unregist/mhi-ac-ctrl-esp32-c3/esphome/components/MhiAcCtrl/MHI-AC-Ctrl-core.cpp

// MHI-AC-Ctrol-core
// implements the core functions (read & write SPI)

#include "MHI-AC-Ctrl-core.h"

#include "freertos/FreeRTOS.h"
#include "freertos/task.h"
#include <math.h>
#include <string.h>

#include "driver/timer.h"
#include "driver/spi_slave.h"
#include "driver/gpio.h"
#define LOG_LOCAL_LEVEL ESP_LOG_DEBUG
#include "esp_log.h"
static const char *TAG = "MHI-AC-CTRL-core";

using namespace mhi_ac;
using namespace mhi_ac::internal;


#define vTaskDelayMs(ms)            vTaskDelay((ms)/portTICK_PERIOD_MS)

#define ESP_INTR_FLAG_DEFAULT       0                                           // default to allocating a non-shared interrupt of level 1, 2 or 3.

#define TIMER_DIVIDER               (16)                                        // hardware timer clock divider
#define TIMER_SCALE_MS              (TIMER_BASE_CLK / TIMER_DIVIDER / 1000)     // convert counter value to milliseconds

static TaskHandle_t mhi_poll_task_handle = NULL;
//                              sb0   sb1   sb2   db0   db1   db2   db3   db4   db5   db6   db7   db8   db9  db10  db11  db12  db13 (db14  chkH  chkL not needed)
static uint8_t miso_frame[] = { 0xA9, 0x00, 0x07, 0x00, 0x00, 0x00, 0xff, 0x00, 0x00, 0x00, 0x00, 0x00, 0x00, 0xff, 0xff, 0xff, 0x0f };
static SemaphoreHandle_t miso_semaphore_handle;
static StaticSemaphore_t miso_semaphore_buffer;

static int gpio_status = 0;
static int ready = 0;
static bool active_mode = false;


static SemaphoreHandle_t snapshot_semaphore_handle;
static StaticSemaphore_t snapshot_semaphore_buffer;
static uint8_t mosi_frame_snapshot[DB14];
static uint8_t mosi_frame_snapshot_prev[DB14];
static uint32_t frame_errors = 0;

namespace mhi_ac {
MHIEnergy mhi_energy(230);


static void IRAM_ATTR gpio_isr_handler(void* arg)
{
    timer_set_counter_value(TIMER_GROUP_0, TIMER_0, 0);
    timer_set_alarm(TIMER_GROUP_0, TIMER_0, TIMER_ALARM_EN);
    //timer_start(TIMER_GROUP_0, TIMER_0);
}

static bool IRAM_ATTR timer_group_isr_callback(void *args)
{
    esp_err_t err;
    BaseType_t xHigherPriorityTaskWoken;
    // Trigger Chip Select
    gpio_set_level(GPIO_CS_OUT, 1);
    if(ready) {
        spi_slave_transaction_t *t = (spi_slave_transaction_t *) args;
        err = spi_slave_queue_trans(RCV_HOST, t, 0);
    }
    //if(err) {
        //gpio_status = 1-gpio_status;
        //gpio_set_level(GPIO_IDK, gpio_status);
    //}
    //gpio_status = 1-gpio_status;
    gpio_set_level(GPIO_CS_OUT, 0);
    //timer_set_counter_value(TIMER_GROUP_0, TIMER_0, 0);
    //timer_set_alarm(TIMER_GROUP_0, TIMER_0, TIMER_ALARM_EN);
    //timer_start(TIMER_GROUP_0, TIMER_0);
    return false;
}

bool mhi_ac_ctrl_core_snapshot(uint32_t wait_time_ms) {
    xSemaphoreTake(snapshot_semaphore_handle, 0);
    return xSemaphoreTake(snapshot_semaphore_handle, pdMS_TO_TICKS(wait_time_ms));
}

void mhi_ac_ctrl_core_active_mode_set(bool state) {
    active_mode = state;
    if(!active_mode) {
        // Ensure we stop counting power when active mode is off
        mhi_energy.set_current(0);
    }
}

bool mhi_ac_ctrl_core_active_mode_get() {
    return active_mode;
}

#define CLAMP(x, lower, upper) (MIN(upper, MAX(x, lower)))

void mhi_ac_ctrl_core_target_temperature_set(float target_temperature) {
    xSemaphoreTake(miso_semaphore_handle, portMAX_DELAY);
    //uint8_t tsetpoint = (uint8_t)roundf(CLAMP(target_temperature*2, 18.f*2, 30.f*2));
    uint8_t tsetpoint = (uint8_t)roundf(CLAMP(target_temperature*2, 0.f*2, 30.f*2));
    miso_frame[DB2] = tsetpoint;
    miso_frame[DB2] |= 1 << 7;      // set bit for temp
    ESP_LOGD(TAG, "Set temperature, new DB2: %x (from source temp %f)", miso_frame[DB2], target_temperature);
    xSemaphoreGive(miso_semaphore_handle);
}

bool mhi_ac_ctrl_core_target_temperature_changed() {
    return mosi_frame_snapshot[DB2] != mosi_frame_snapshot_prev[DB2];
}

float mhi_ac_ctrl_core_target_temperature_get() {
    float temp = mosi_frame_snapshot[DB2] &~ (1 << 7);
    return temp / 2.0f;
}

bool mhi_ac_ctrl_core_power_changed() {
    return (mosi_frame_snapshot[DB0] & PWR_MASK) != (mosi_frame_snapshot_prev[DB0] & PWR_MASK);
}

void mhi_ac_ctrl_core_power_set(ACPower power) {
    xSemaphoreTake(miso_semaphore_handle, portMAX_DELAY);
    miso_frame[DB0] &= ~PWR_MASK;                       // clear what is there first
    miso_frame[DB0] |= (uint8_t)power;                  // set the setting
    miso_frame[DB0] |= 1 << 1;                          // DB0[1] 'set setting bit'
    xSemaphoreGive(miso_semaphore_handle);
}

ACPower mhi_ac_ctrl_core_power_get() {
    if(mosi_frame_snapshot[DB0] & PWR_MASK)
        return ACPower::power_on;
    else
        return ACPower::power_off;
}

bool mhi_ac_ctrl_core_mode_changed() {
    return (mosi_frame_snapshot[DB0] & MODE_MASK) != (mosi_frame_snapshot_prev[DB0] & MODE_MASK);
}

void mhi_ac_ctrl_core_mode_set(ACMode mode) {
    if(mode == ACMode::mode_unknown) {
        return;
    }
    xSemaphoreTake(miso_semaphore_handle, portMAX_DELAY);
    miso_frame[DB0] &= ~MODE_MASK;                      // clear what is there first
    miso_frame[DB0] |= (uint8_t)mode;                   // set the setting
    miso_frame[DB0] |= 1 << 5;                          // 'set setting bit for mode'
    xSemaphoreGive(miso_semaphore_handle);
}

ACMode mhi_ac_ctrl_core_mode_get() {
    uint8_t current_mode = mosi_frame_snapshot[DB0] & MODE_MASK;
    switch(current_mode) {
        case (uint8_t)ACMode::mode_auto:
        case (uint8_t)ACMode::mode_dry:
        case (uint8_t)ACMode::mode_cool:
        case (uint8_t)ACMode::mode_fan:
        case (uint8_t)ACMode::mode_heat:
            return (ACMode) current_mode;
        default:
            return ACMode::mode_unknown;
    }
}

bool mhi_ac_ctrl_core_fan_changed() {
    return (mosi_frame_snapshot[DB1] & FAN_MASK) != (mosi_frame_snapshot_prev[DB1] & FAN_MASK);

}
void mhi_ac_ctrl_core_fan_set(ACFan fan) {
    xSemaphoreTake(miso_semaphore_handle, portMAX_DELAY);
    //miso_frame[DB1] &= ~FAN_DB1_MASK;
    //miso_frame[DB6] &= ~FAN_DB6_MASK;
    //switch(fan) {
        //case ACFan::speed1:
        //case ACFan::speed2:
        //case ACFan::speed3:
            //miso_frame[DB1] |= (uint8_t) fan;
            //break;
        //case ACFan::speed4:
            //miso_frame[DB1] |= (uint8_t) ACFan::speed3;
            //miso_frame[DB6] |= (uint8_t) ACFan::speed4;
            //break;
    //}
    miso_frame[DB1] &= ~FAN_MASK;
    miso_frame[DB1] |= (uint8_t) fan;
    miso_frame[DB1] |= 1 << 3;              // set bit for fan speed on DB1
    xSemaphoreGive(miso_semaphore_handle);
}

ACFan mhi_ac_ctrl_core_fan_get() {
    uint8_t fan_value = mosi_frame_snapshot[DB1] & FAN_MASK;
    switch(fan_value) {
        case (uint8_t) ACFan::speed_1:
        case (uint8_t) ACFan::speed_2:
        case (uint8_t) ACFan::speed_3:
        case (uint8_t) ACFan::speed_4:
        case (uint8_t) ACFan::speed_auto:
            return (ACFan) fan_value;
        default:
            return ACFan::unknown;
    }
}

bool mhi_ac_ctrl_core_fan_old_changed() {
    return (mosi_frame_snapshot[DB1] & FAN_DB1_MASK) != (mosi_frame_snapshot_prev[DB1] & FAN_DB1_MASK)
        || (mosi_frame_snapshot[DB6] & FAN_DB6_MASK) != (mosi_frame_snapshot_prev[DB6] & FAN_DB6_MASK);
}

uint8_t mhi_ac_ctrl_core_fan_old_get() {
    if(mosi_frame_snapshot[DB6] & FAN_SPEED_4) {
        return 100;
    }
    uint8_t db1_value = mosi_frame_snapshot[DB1] & FAN_DB1_MASK;
    switch(db1_value) {
        case FAN_SPEED_1:
            return 25;
        case FAN_SPEED_2:
            return 50;
        case FAN_SPEED_3:
            return 75;
    }
    return 0xff;
}

uint8_t mhi_ac_ctrl_core_fan_get_raw() {
    return mosi_frame_snapshot[DB1] & FAN_MASK;
}

bool mhi_ac_ctrl_core_current_temperature_changed() {
    return mosi_frame_snapshot[DB3] != mosi_frame_snapshot_prev[DB3];
}

float mhi_ac_ctrl_core_current_temperature_get() {
    return ((int)mosi_frame_snapshot[DB3] - 61) / 4.0;
}

bool mhi_ac_ctrl_core_compressor_changed() {
    return (mosi_frame_snapshot[DB13] & COMP_ACTIVE_MASK) != (mosi_frame_snapshot_prev[DB13] & COMP_ACTIVE_MASK);
}

bool mhi_ac_ctrl_core_compressor_get() {
    return mosi_frame_snapshot[DB13] & COMP_ACTIVE_MASK;
}

bool mhi_ac_ctrl_core_heatcool_changed() {
    return (mosi_frame_snapshot[DB13] & HEAT_COOL_MASK) != (mosi_frame_snapshot_prev[DB13] & HEAT_COOL_MASK);
}

bool mhi_ac_ctrl_core_heatcool_get() {
    return mosi_frame_snapshot[DB13] & HEAT_COOL_MASK;
}

uint32_t mhi_ac_ctrl_core_frame_errors_get() {
    return frame_errors;
}

bool mhi_ac_ctrl_core_vanes_updown_changed() {
    return (mosi_frame_snapshot[DB0] & 0x40) != (mosi_frame_snapshot_prev[DB0] & 0x40) ||
        (mosi_frame_snapshot[DB1] & 0x30) != (mosi_frame_snapshot_prev[DB1] & 0x30);
}

ACVanes mhi_ac_ctrl_core_vanes_updown_get() {
    if(mosi_frame_snapshot[DB0] & 0x40) {
        return ACVanes::swing;
    }
    switch (mosi_frame_snapshot[DB0] & 0x30) {
        case 0x00:
            return ACVanes::vanes_1;
        case 0x10:
            return ACVanes::vanes_2;
        case 0x20:
            return ACVanes::vanes_3;
        case 0x30:
        default:
            return ACVanes::vanes_4;
    }
}

void mhi_ac_ctrl_core_vanes_updown_set(ACVanes new_state) {
    xSemaphoreTake(miso_semaphore_handle, portMAX_DELAY);

    miso_frame[DB0] |= 0x80; // Swing set
    if(new_state == ACVanes::swing) {
        miso_frame[DB0] |= 0x40; // Enable swing
    } else {
        miso_frame[DB0] &= ~0x40; 
        miso_frame[DB1] |= 0x80; // Pos set
        miso_frame[DB1] |= ((uint8_t) new_state) << 4;
    }
    xSemaphoreGive(miso_semaphore_handle);
}


static void mhi_poll_task(void *arg)
{
    esp_err_t err;

    uint16_t packet_cnt = 0;            // can be removed when diagnostic lines are removed

    uint8_t frame = 0;
    bool halfcycle = false;


    uint16_t rx_checksum = 0;
    uint16_t tx_checksum = 0;
    bool frame_diff = false;
    bool have_miso_semaphore = false;

    const char *mode ;                         // can be removed when diagnostic lines are removed
    const char *state;                        // can be removed when diagnostic lines are removed
    uint8_t mhi_fan_speed;

    uint8_t active;                     // off, on
    uint8_t target_state;               // auto, heat, cool
    uint8_t current_state;              // inactive, idle, heating, cooling; look at compressor status in DB13
    float current_temp, set_temp;

    // use WORD_ALIGNED_ATTR when using DMA buffer
    WORD_ALIGNED_ATTR uint8_t recvbuf[MHI_FRAME_LEN];
    WORD_ALIGNED_ATTR uint8_t sendbuf[MHI_FRAME_LEN];

    uint8_t mosi_frame[MHI_FRAME_LEN];

    // configuration for the SPI bus
    spi_bus_config_t buscfg={
        .mosi_io_num = GPIO_MOSI,
        .miso_io_num = GPIO_MISO,
        .sclk_io_num = GPIO_SCLK,
        .quadwp_io_num = -1,
        .quadhd_io_num = -1,
		.data4_io_num = -1,
		.data5_io_num = -1,
		.data6_io_num = -1,
		.data7_io_num = -1,
		//.max_transfer_sz = 4092, // Defaults to 4092 if 0 when DMA enabled, or to SOC_SPI_MAXIMUM_BUFFER_SIZE if DMA is disabled. 
		//.intr_flags = , // Unsure what to set to
        .flags = SPICOMMON_BUSFLAG_GPIO_PINS | SPICOMMON_BUSFLAG_SLAVE,
    };

    // configuration for the SPI slave interface
    spi_slave_interface_config_t slvcfg={
        .spics_io_num = GPIO_CS_IN,
        .flags = SPI_SLAVE_BIT_LSBFIRST,
        .queue_size = 1,
        .mode = 3,                    //CPOL=1, CPHA=1
		//.post_trans_cb = , //Unsure
    };

    spi_slave_transaction_t spi_slave_trans;
    spi_slave_transaction_t* spi_slave_trans_out;       // needed for spi_slave_get_trans_result which needs a pointer to a pointer

    // initialize SPI slave interface
    err = spi_slave_initialize(RCV_HOST, &buscfg, &slvcfg, SPI_DMA_CH_AUTO);    // can't disable DMA. no comms if you do...

    ESP_ERROR_CHECK(err);


    // Select and initialize basic parameters of the timer
    timer_config_t config = {
        .alarm_en = TIMER_ALARM_DIS,
        .counter_en = TIMER_PAUSE,
        .counter_dir = TIMER_COUNT_UP,
        .auto_reload = TIMER_AUTORELOAD_DIS,
        .divider = TIMER_DIVIDER,
		//.intr_type = , //
		//.clk_src = ,//
    }; // default clock source is APB
    timer_init(TIMER_GROUP_0, TIMER_0, &config);

    // Configure the alarm value (in milliseconds) and the interrupt on alarm. there is a delay between each frame of 40ms.
    //  so we set the alarm to 20ms. once the alarm triggers, spi_slave_queue_trans is called which will get the data from the next spi packet. This is also the point to toggle the CS line to mark the end/start of a SPI transaction.
    timer_set_alarm_value(TIMER_GROUP_0, TIMER_0, 20 * TIMER_SCALE_MS);
    timer_enable_intr(TIMER_GROUP_0, TIMER_0);
    timer_isr_callback_add(TIMER_GROUP_0, TIMER_0, timer_group_isr_callback, &spi_slave_trans, 0);
    timer_start(TIMER_GROUP_0, TIMER_0);

    gpio_config_t io_conf = {};
    io_conf.mode = GPIO_MODE_INPUT;
    io_conf.pin_bit_mask = (1ULL<<GPIO_SCLK);
    io_conf.pull_down_en = GPIO_PULLDOWN_DISABLE;
    io_conf.pull_up_en = GPIO_PULLUP_ENABLE;                                     // required to prevent abort() caused by floating pin when daughtboard not connected
    io_conf.intr_type = GPIO_INTR_LOW_LEVEL;                    // when this is set to NEGEDGE, DMA sometimes doesn't read the last 4 bytes
                                                                // if not connected to AC (plugged in) when starting, it will crash - probably because it
                                                                // immediately calls an interrupt
    gpio_config(&io_conf);



    gpio_install_isr_service(ESP_INTR_FLAG_DEFAULT);
    gpio_isr_handler_add(GPIO_SCLK, gpio_isr_handler, NULL);
    //gpio_intr_disable(GPIO_SCLK);
    gpio_intr_enable(GPIO_SCLK);

    io_conf.mode = GPIO_MODE_OUTPUT;
    io_conf.pin_bit_mask = (1ULL<<GPIO_CS_OUT);
    io_conf.intr_type =GPIO_INTR_DISABLE;
    io_conf.pull_up_en = GPIO_PULLUP_DISABLE;
    gpio_config(&io_conf);

    gpio_set_level(GPIO_CS_OUT, 1);

    io_conf.mode = GPIO_MODE_OUTPUT;
    io_conf.pin_bit_mask = (1ULL<<GPIO_IDK);
    io_conf.intr_type =GPIO_INTR_DISABLE;
    io_conf.pull_up_en = GPIO_PULLUP_DISABLE;
    gpio_config(&io_conf);

    gpio_set_level(GPIO_IDK, 0);

    //Set up a transaction of MHI_FRAME_LEN bytes to send/receive
    spi_slave_trans.length = MHI_FRAME_LEN*8;
    spi_slave_trans.tx_buffer = sendbuf;
    spi_slave_trans.rx_buffer = recvbuf;

    while(1) {
        frame_diff = false;
        packet_cnt++;

        if(!active_mode) {
            memset(sendbuf, 0xff, sizeof sendbuf);
        } else if (frame++ >= MHI_NUM_FRAMES_PER_INTERVAL) {
            halfcycle = !halfcycle;                     // toggle
            frame = 1;                                  // 2 * MHI_NUM_FRAMES_PER_INTERVAL make a complete cycle. for half that,
            // MISO_frame[DB14] bit2 is 0, and the other half it is 1. When it is set to 1
            // the MISO can be set with any new settings
            if (halfcycle && xSemaphoreTake(miso_semaphore_handle, 0) == pdTRUE) {
                memcpy(sendbuf, miso_frame, sizeof(miso_frame));
                //request current
                sendbuf[DB6] = 0x40;
                sendbuf[DB9] = 0x90; //current
                // we never change those, right?
                //sendbuf[DB10] = 0xff;
                //sendbuf[DB11] = 0xff;
                //sendbuf[DB12] = 0xff;

                // to set a setting, the same bits are set in the MISO frame
                // that they are located in the MOSI frame. you also need to
                // set a specific 'set bit'. this bit stays set (even in the
                // MOSI frame) until the RC is used. at this point, _all_ set
                // bits are reset to 0 since we just copied all the new
                // configuration to the sendbuf. if the RC is used, the
                // updated setting will appear in the MOSI frame, which is
                // updated every frame. once every ~40 frames (2 *
                // MHI_NUM_FRAMES_PER_INTERVAL), the MISO frame is set (in
                // this loop) with any settings that have changed in the ESP

                miso_frame[DB0] = 0x00;
                miso_frame[DB1] = 0x00;
                miso_frame[DB2] = 0x00;
                xSemaphoreGive(miso_semaphore_handle);
            }

            // DB14 bit2 toggles periodically (about every 20 frames)
            sendbuf[DB14] = halfcycle << 2;

            // calculate checksum
            tx_checksum = 0;
            for (uint8_t byte_cnt = 0; byte_cnt < CBH; byte_cnt++) {
                tx_checksum += sendbuf[byte_cnt];
            }

            sendbuf[CBH] = tx_checksum>>8;
            sendbuf[CBL] = tx_checksum;
        }

        // reset timer and enable alarm (alarm disables after it has triggered once)
        //timer_set_counter_value(TIMER_GROUP_0, TIMER_0, 0);
        //timer_set_alarm(TIMER_GROUP_0, TIMER_0, TIMER_ALARM_EN);
        //timer_start(TIMER_GROUP_0, TIMER_0);

        // enable the interrupt which will reset the timer counter to 0 every time it goes LOW
        //gpio_intr_enable(GPIO_SCLK);


        // blocking function waiting for the spi results. the hardware timer must reach 20ms and perform an spi transaction
        //  we can get the data directly from 'spi_slave_trans' instead of 'spi_slave_trans_out->'
        ready= true;
        //ESP_LOGI(TAG, "waiting for trans semaphore");
        err = spi_slave_get_trans_result(RCV_HOST, &spi_slave_trans_out, portMAX_DELAY);
        ready= false;
        if(err) {
            ESP_LOGE(TAG, "get_trans_result error: %i", err);
        }

        // timer and gpio interrupt are not required until next cycle
        //timer_pause(TIMER_GROUP_0, TIMER_0);
        //gpio_intr_disable(GPIO_SCLK);
        //gpio_set_level(GPIO_CS_OUT, 1);

        rx_checksum = 0;
        for (uint8_t byte_cnt = 0; byte_cnt < MHI_FRAME_LEN; byte_cnt++) {
            // calculate checksum
            if (byte_cnt < 18){
                rx_checksum += recvbuf[byte_cnt];
            }

            // check if any bytes have changed
            if (mosi_frame[byte_cnt] != recvbuf[byte_cnt]) {
                mosi_frame[byte_cnt] = recvbuf[byte_cnt];
                frame_diff = true;
            }
        }

        bool frame_error = false;

        // check for errors. first byte should be 0x6c
        if ( ((mosi_frame[SB0] & 0xfe) != 0x6c) | (mosi_frame[SB1] != 0x80) | (mosi_frame[SB2] != 0x04) ) {
            ESP_LOGW(TAG, "packet: %5d wrong MOSI signature. 0x%02x 0x%02x 0x%02x",
                        packet_cnt, mosi_frame[0], mosi_frame[1], mosi_frame[2]);


            frame_error = true;
            //TODO: store CRC error counter for home assistant?
        } else if ( (mosi_frame[CBH] != (rx_checksum>>8 & 0xff)) | (mosi_frame[CBL] != (rx_checksum & 0xff)) ) {
            ESP_LOGW(TAG, "packet: %5d wrong MOSI checksum. calculated 0x%04x. MOSI[18]:0x%02x MOSI[19]:0x%02x",
                        packet_cnt, rx_checksum, mosi_frame[18], mosi_frame[19]);

            frame_error = true;
            //TODO: store CRC error counter for home assistant?
        }

        if (frame_error) {
            ESP_LOGW(TAG, "length: %i, trans len: %i",spi_slave_trans.length, spi_slave_trans.trans_len);
            frame_errors++;

            // wait a second before retrying communication
            gpio_set_level(GPIO_IDK, 1);
            vTaskDelayMs(1000);
            gpio_set_level(GPIO_IDK, 0);
        } else {
            // Make snapshot if requested
            if(xSemaphoreTake(snapshot_semaphore_handle, 0) != pdTRUE) {
                memcpy(mosi_frame_snapshot_prev, mosi_frame_snapshot, sizeof(mosi_frame_snapshot_prev));
                memcpy(mosi_frame_snapshot, recvbuf, sizeof(mosi_frame_snapshot));
            }
            xSemaphoreGive(snapshot_semaphore_handle);
        }



        // ********************** Diagnostics ************************
/*
        if (frame == 1) {
            printf("miso packet: %5d    %02x %02x %02x   %02x %02x %02x %02x %02x %02x %02x %02x %02x %02x %02x %02x %02x %02x %02x   %02x %02x (calc %d)  tx_checksum: %d \n",
                packet_cnt,
            sendbuf[0],  sendbuf[1],  sendbuf[2],  sendbuf[3],  sendbuf[4],  sendbuf[5],  sendbuf[6],  sendbuf[7],  sendbuf[8],  sendbuf[9],
            sendbuf[10], sendbuf[11], sendbuf[12], sendbuf[13], sendbuf[14], sendbuf[15], sendbuf[16], sendbuf[17], sendbuf[18], sendbuf[19],
                (sendbuf[18]<<8)+(sendbuf[19]),
                tx_checksum
            );
            printf("mosi packet: %5d    %02x %02x %02x   %02x %02x %02x %02x %02x %02x %02x %02x %02x %02x %02x %02x %02x %02x %02x   %02x %02x (calc %d)  rx_checksum: %d \n",
                    packet_cnt,
                mosi_frame[0],  mosi_frame[1],  mosi_frame[2],  mosi_frame[3],  mosi_frame[4],  mosi_frame[5],  mosi_frame[6],  mosi_frame[7],  mosi_frame[8],  mosi_frame[9],
                mosi_frame[10], mosi_frame[11], mosi_frame[12], mosi_frame[13], mosi_frame[14], mosi_frame[15], mosi_frame[16], mosi_frame[17], mosi_frame[18], mosi_frame[19],
                    (mosi_frame[18]<<8)+(mosi_frame[19]),
                    rx_checksum
                );
        }
        if (frame == 2) {
            printf("mosi packet: %5d    %02x %02x %02x   %02x %02x %02x %02x %02x %02x %02x %02x %02x %02x %02x %02x %02x %02x %02x   %02x %02x (calc %d)  rx_checksum: %d \n",
                    packet_cnt,
                mosi_frame[0],  mosi_frame[1],  mosi_frame[2],  mosi_frame[3],  mosi_frame[4],  mosi_frame[5],  mosi_frame[6],  mosi_frame[7],  mosi_frame[8],  mosi_frame[9],
                mosi_frame[10], mosi_frame[11], mosi_frame[12], mosi_frame[13], mosi_frame[14], mosi_frame[15], mosi_frame[16], mosi_frame[17], mosi_frame[18], mosi_frame[19],
                    (mosi_frame[18]<<8)+(mosi_frame[19]),
                    rx_checksum
                );
            printf("\n");
        }
*/
        // ***********************************************************


        // only need to perform updates if there was a change (with no error) since last frame read
        if (frame_diff && !frame_error) {
            // Evaluate Operating Data and Error Operating Data
            bool MOSI_type_opdata = (mosi_frame[DB10] & 0x30) == 0x10;

            if(mosi_frame[DB9] == 0x90) {
                if ((mosi_frame[DB6] & 0x80) == 0) {  // 29 CT
                    if (MOSI_type_opdata) {
                        mhi_energy.set_current(mosi_frame[DB11]);
                        //float current = ((int)mosi_frame[DB11] * 14) / 51.0f;
                        //ESP_LOGI(TAG, "Current: %f, raw: %i, *230: %f", current, mosi_frame[DB11], current*230);
                        //gpio_status = 1-gpio_status;
                        //gpio_set_level(GPIO_IDK, gpio_status);
                    }
                    else {
                        ESP_LOGW(TAG, "Current: error: %i", mosi_frame[DB11]);
                    }
                }
            }
            switch (mosi_frame[DB0] & MODE_MASK)
            {
                case MODE_AUTO:
                    target_state = 0;
                    mode = "auto";
                    break;
                case MODE_HEAT:
                    target_state = 1;
                    mode = "heat";
                    break;
                case MODE_COOL:
                    target_state = 2;
                    mode = "cool";
                    break;

                case MODE_DRY:
                    target_state = 0;
                    mode = "dry";
                    break;
                case MODE_FAN:
                    target_state = 0;
                    mode = "fan";
                    break;
                default:
                    target_state = 0;
                    mode = "unknown";
                    break;
            }

            // this is the power state and the compressor state
            if (!(mosi_frame[DB0] & PWR_MASK)) {
                active = 0;
                current_state = 0;
                state = "inactive";
            } else if (!(mosi_frame[DB13] & COMP_ACTIVE_MASK)) {
                active = 1;
                current_state = 1;
                state = "idle";
            } else if (mosi_frame[DB13] & HEAT_COOL_MASK) {
                active = 1;
                current_state = 2;
                state = "heating";
            } else {
                active = 1;
                current_state = 3;
                state = "cooling";
            }

            current_temp = ((int)mosi_frame[DB3] - 61) / 4.0;

            // this needs to behave differently based on mode
            // save heating and cooling threshold separately
            // if auto, set cool and heat threshold around mid-point (determined by TEMP_THRESHOLD_DIFF)
            set_temp = (int)(mosi_frame[DB2] & 0x7F) / 2.0;

            mhi_fan_speed = mosi_frame[DB1] & FAN_MASK;

            // ********************** Diagnostics ************************

            ESP_LOGD(TAG, "packet: %5d    %02x %02x %02x   %02x %02x %02x %02x %02x %02x %02x %02x %02x %02x %02x %02x %02x %02x %02x   %02x %02x (calc %d)  rx_checksum: %d",
                    packet_cnt,
                mosi_frame[0],  mosi_frame[1],  mosi_frame[2],  mosi_frame[3],  mosi_frame[4],  mosi_frame[5],  mosi_frame[6],  mosi_frame[7],  mosi_frame[8],  mosi_frame[9],
                mosi_frame[10], mosi_frame[11], mosi_frame[12], mosi_frame[13], mosi_frame[14], mosi_frame[15], mosi_frame[16], mosi_frame[17], mosi_frame[18], mosi_frame[19],
                    (mosi_frame[18]<<8)+(mosi_frame[19]),
                    rx_checksum
                );

            ESP_LOGD(TAG, "            power: %3s  mode: %5s  temp: %2.2f  set_temp: %2.2f  mhi_fan_speed: %d  state: %8s",
                (mosi_frame[DB0] & PWR_MASK) ? "on" : "off",
                mode,
                current_temp,
                set_temp,
                mhi_fan_speed,
                state
            );

            // ***********************************************************

        }
    }
}

void mhi_ac_ctrl_core_init() {
    esp_log_level_set(TAG,ESP_LOG_DEBUG);
    ESP_LOGD(TAG, "This debug message");
    miso_semaphore_handle = xSemaphoreCreateMutexStatic( &miso_semaphore_buffer );
    snapshot_semaphore_handle = xSemaphoreCreateBinaryStatic( &snapshot_semaphore_buffer );

    xTaskCreatePinnedToCore(
                        mhi_poll_task,          // Function to implement the task
                        "mhi_task",             // Name of the task
                        4096,                   // Stack size in words
                        NULL,                   // Task input parameter
                        10,                     // Priority of the task
                        &mhi_poll_task_handle,  // Task handle.
                        1);                     // Core where the task should run

}
} //namespace mhi_ac
