unregist/mhi-ac-ctrl-esp32-c3/(commit log)

2024-10-27 Custom Version for ESP32-C3-DevkitM-1
    Custom Version for ESP32-C3-DevkitM-1
    [MHI-AC-CTRL.kicad_pcb, MHI-AC-CTRL.kicad_sch]
2024-10-28 Update MHI-AC-Ctrl-core.cpp
    Change hardcoded PINs to PIN definitions in MHI-AC-Ctrl-Core.h
2024-10-29 Update MHI-AC-Ctrl-core.h
    Changing PINs to ESP32 (non-C3) compatible PINs for testing while I wait for my ESP32-C3 in the post :)
